Amir-imani/Autonomous-Mobile-Robot/mechanical/2.pdf

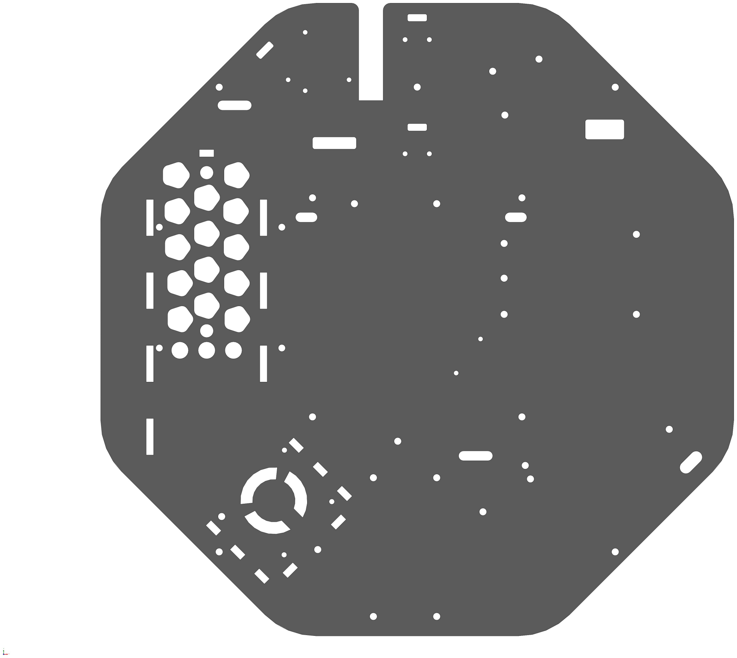
[picture p7: page 1]
