Amir-imani/Autonomous-Mobile-Robot/mechanical/AS5600.pdf

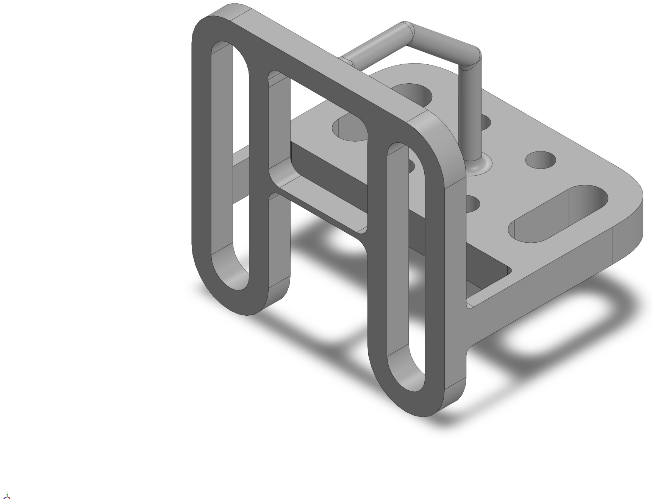
[picture p8: page 1]
