Amir-imani/Autonomous-Mobile-Robot/mechanical/camera holder.pdf

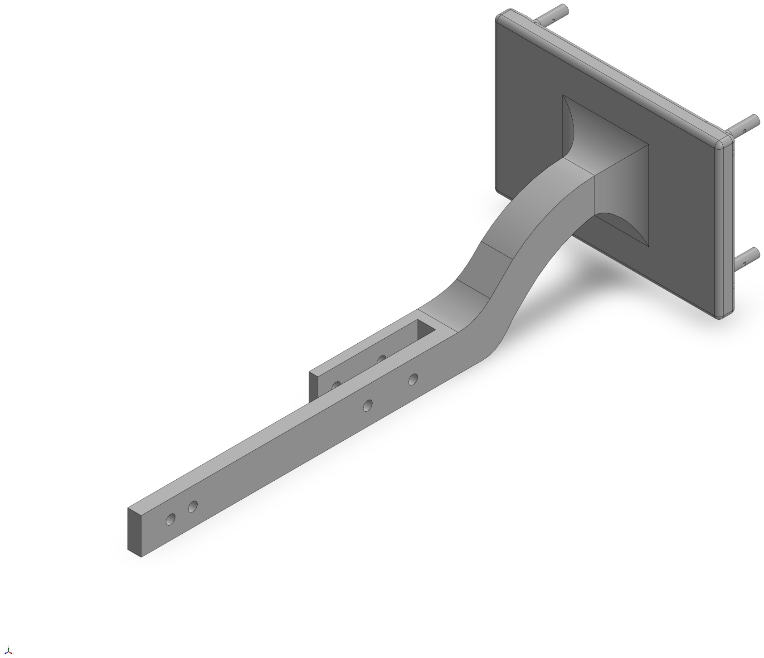
[picture p9: page 1]
