Amir-imani/Autonomous-Mobile-Robot/mechanical/encoder_couplers/magnet_shaft_coupler.pdf

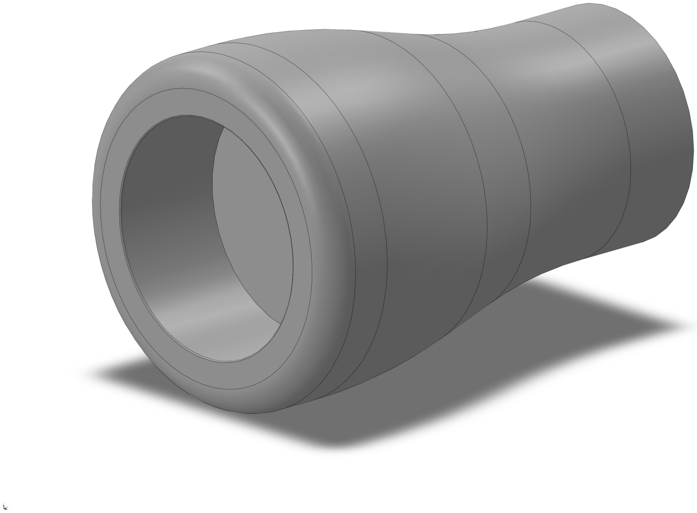
[picture p10: page 1]
