Amir-imani/Autonomous-Mobile-Robot/mechanical/motor_mounts/motor_mount_bracket.pdf

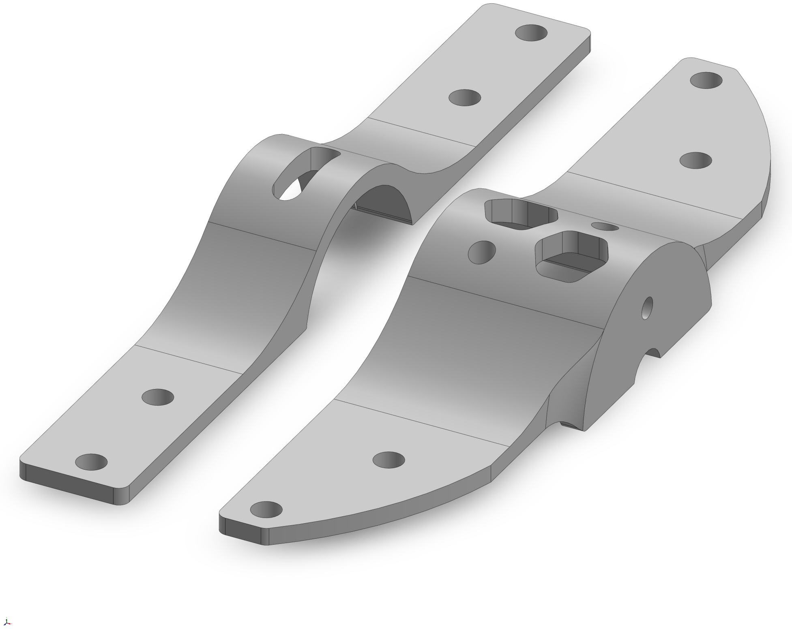
[picture p11: page 1]
