Amir-imani/Autonomous-Mobile-Robot/mechanical/sensor_mounts/lidar_mount.pdf

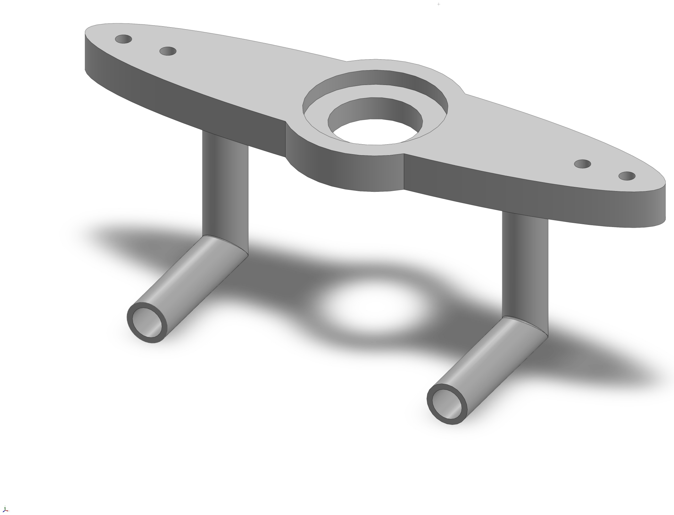
[picture p12: page 1]
