Amir-imani/Autonomous-Mobile-Robot/mechanical/thermal_airflow/raspberry_pi5_fan_duct.pdf

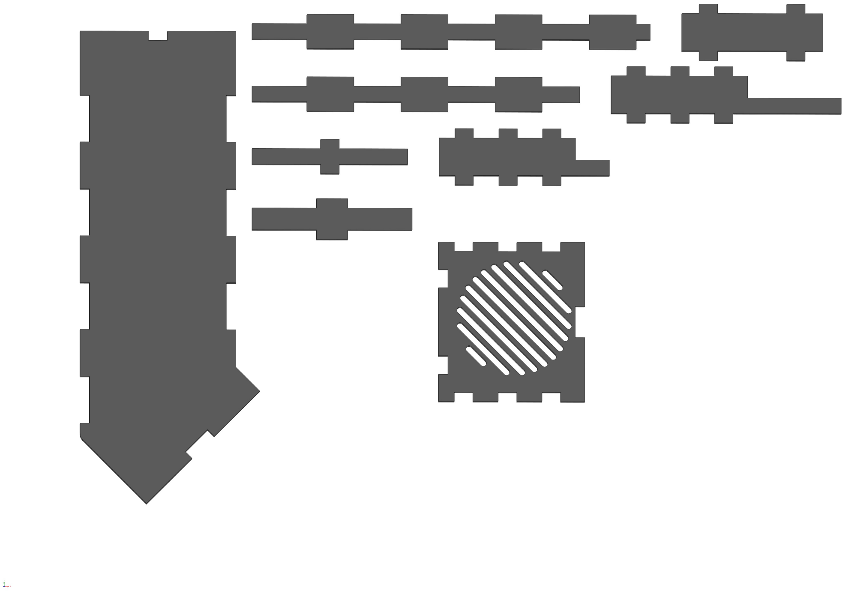
[picture p13: page 1]
