Amir-imani/Autonomous-Mobile-Robot/mechanical/chassis/lower_deck/lower_chassis_plate.pdf

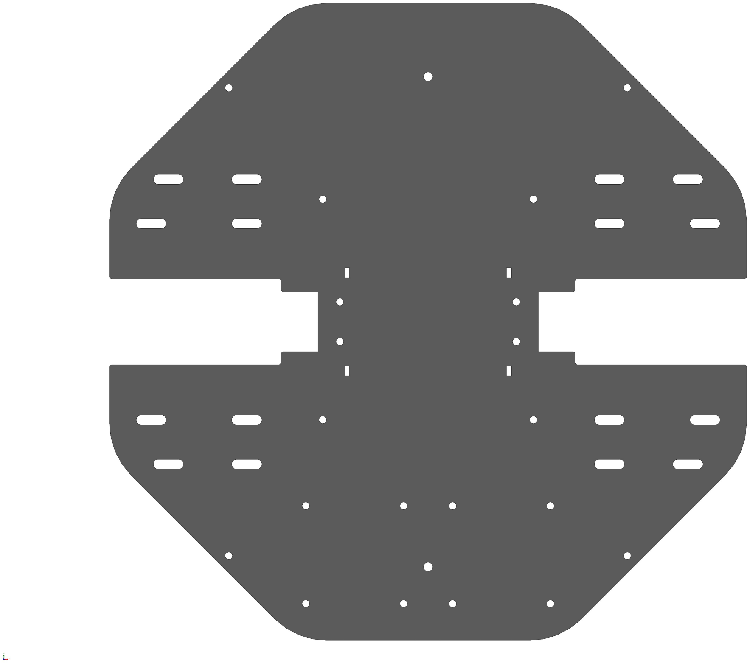
[picture p14: page 1]
