Amir-imani/Autonomous-Mobile-Robot/mechanical/chassis/lower_deck/lower_chassis_plate.SLDPRT

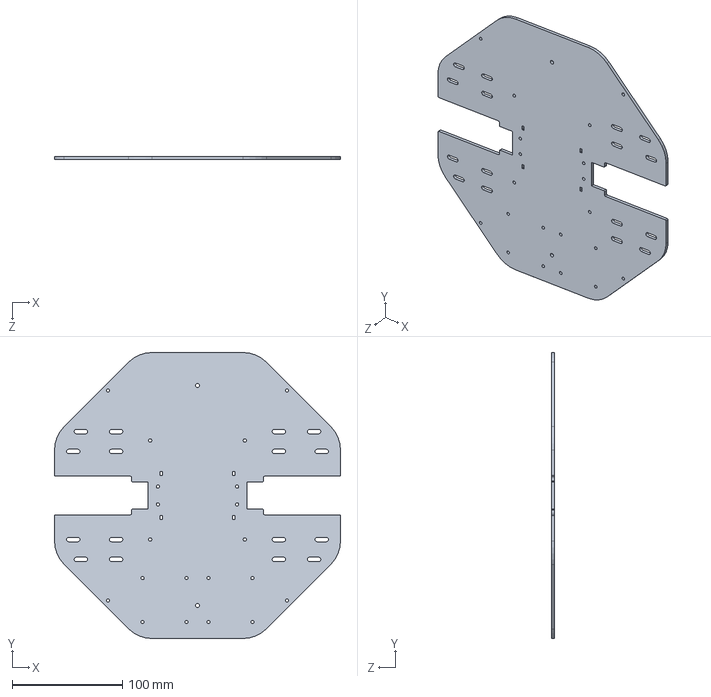
[picture p15: CAD file, 2026-10-11]
mechanical/chassis/lower_deck/lower_chassis_plate.SLDPRT
260.0 x 260.0 x 3.00 mm
