Amir-imani/Autonomous-Mobile-Robot/mechanical/motor_mounts/motor_mount_bracket.STL

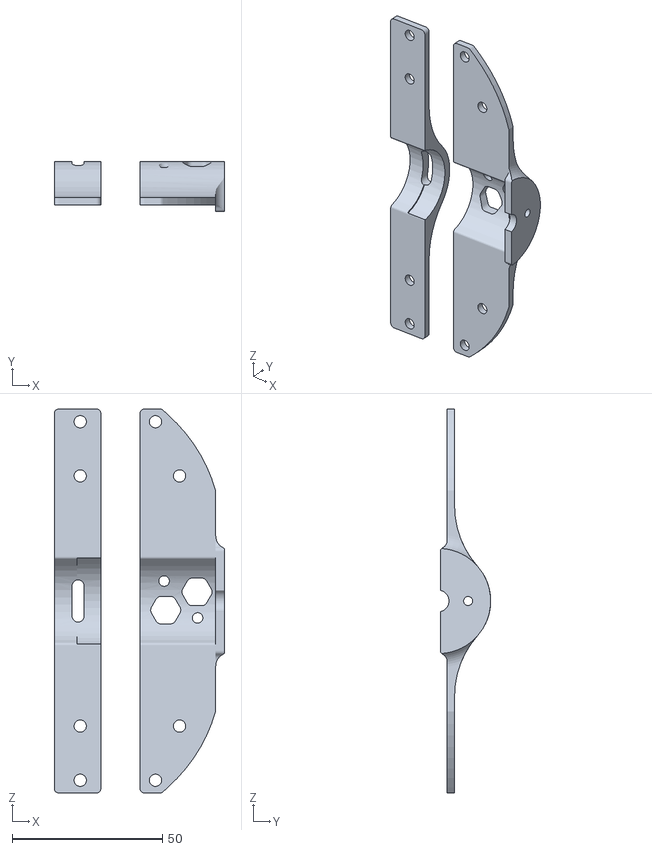
[picture p16: CAD file, 2026-10-11]
mechanical/motor_mounts/motor_mount_bracket.STL
56.6 x 16.7 x 127.6
