Amir-imani/Autonomous-Mobile-Robot/mechanical/sensor_mounts/lidar_mount.SLDPRT

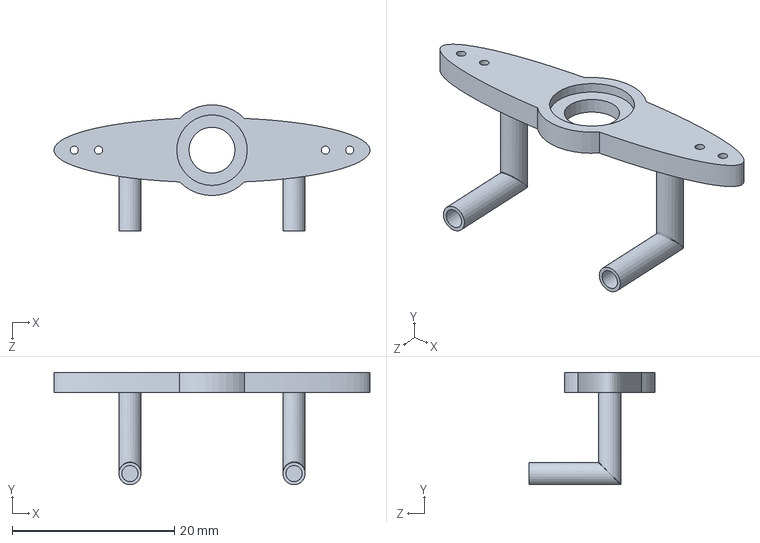
[picture p17: CAD file, 2026-10-11]
mechanical/sensor_mounts/lidar_mount.SLDPRT
39.0 x 13.9 x 15.6 mm
