Amir-imani/Autonomous-Mobile-Robot/mechanical/Side.SLDPRT

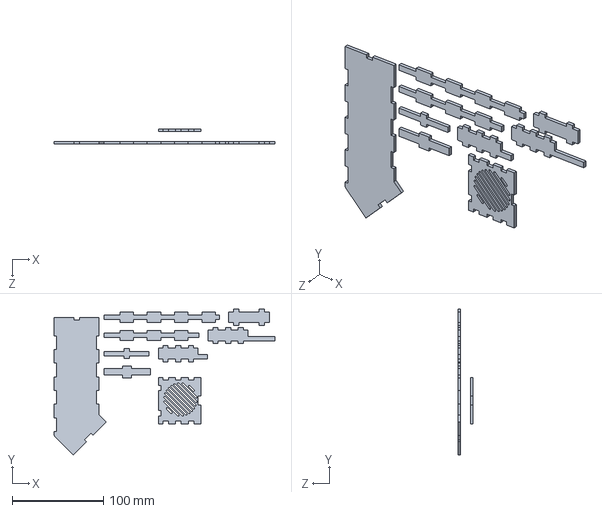
[picture p18: CAD file, 2026-10-11]
mechanical/Side.SLDPRT
242.7 x 160.2 x 16.9 mm
