Amir-imani/Autonomous-Mobile-Robot/mechanical/sensor_mounts/camera_mount.SLDPRT

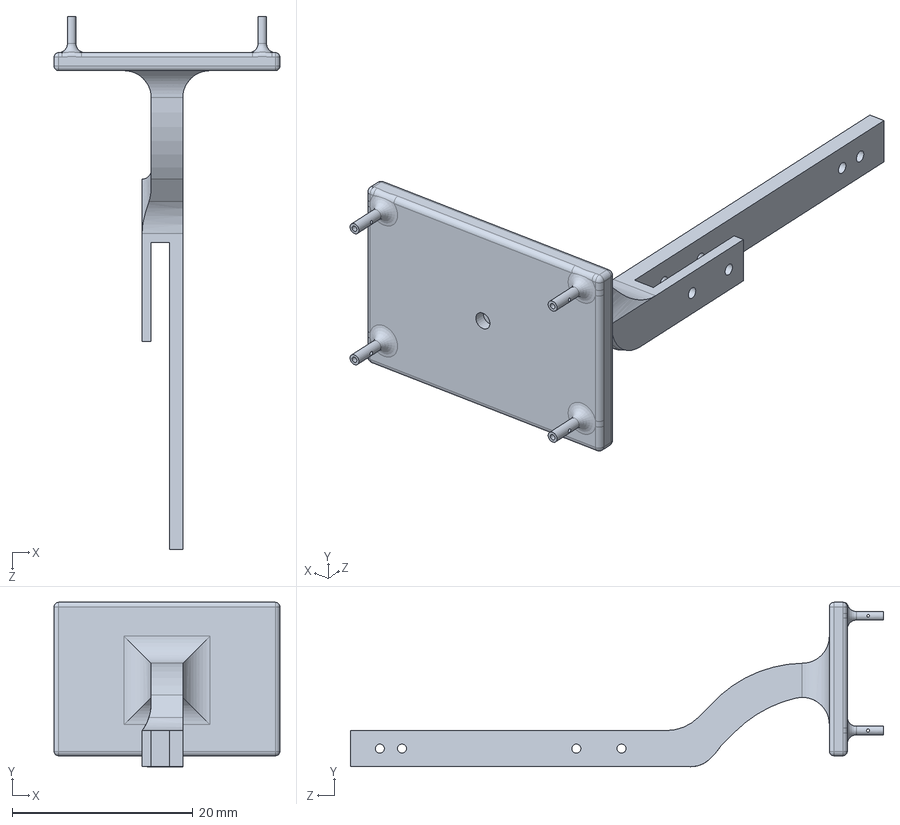
[picture p19: CAD file, 2026-10-11]
mechanical/sensor_mounts/camera_mount.SLDPRT
25.0 x 18.2 x 59.0 mm
