Amir-imani/Autonomous-Mobile-Robot/mechanical/Part21.SLDPRT

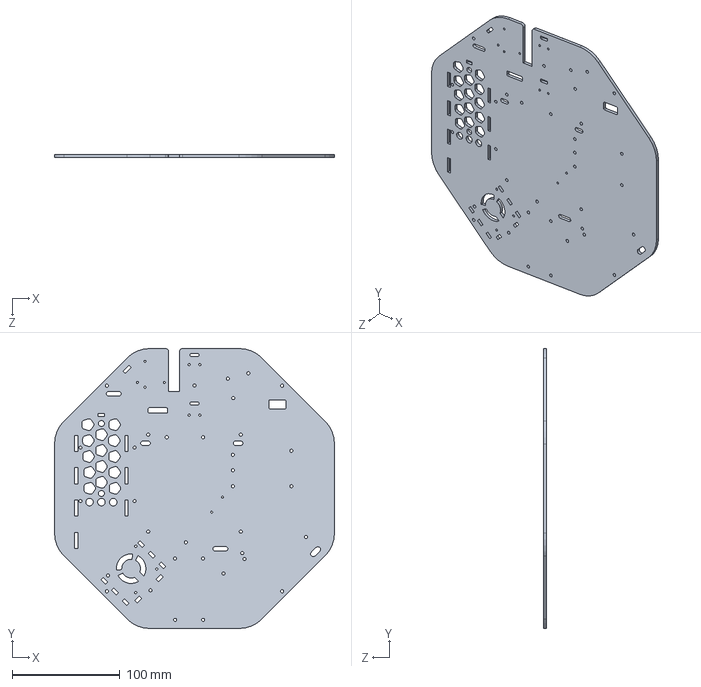
[picture p20: CAD file, 2026-10-11]
mechanical/Part21.SLDPRT
260.0 x 260.0 x 3.00 mm
