Amir-imani/Autonomous-Mobile-Robot/mechanical/sensor_mounts/as5600_encoder_mount.SLDPRT

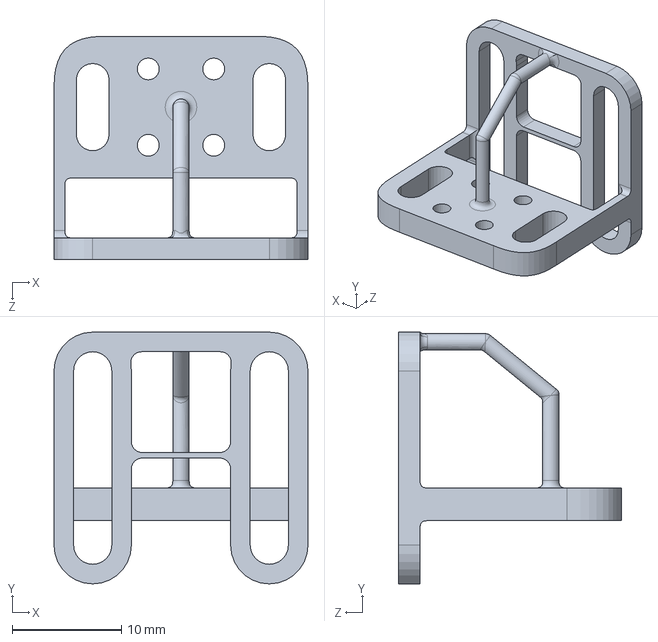
[picture p21: CAD file, 2026-10-11]
mechanical/sensor_mounts/as5600_encoder_mount.SLDPRT
23.3 x 23.1 x 20.5 mm
