Amir-imani/Autonomous-Mobile-Robot/mechanical/mag.SLDPRT

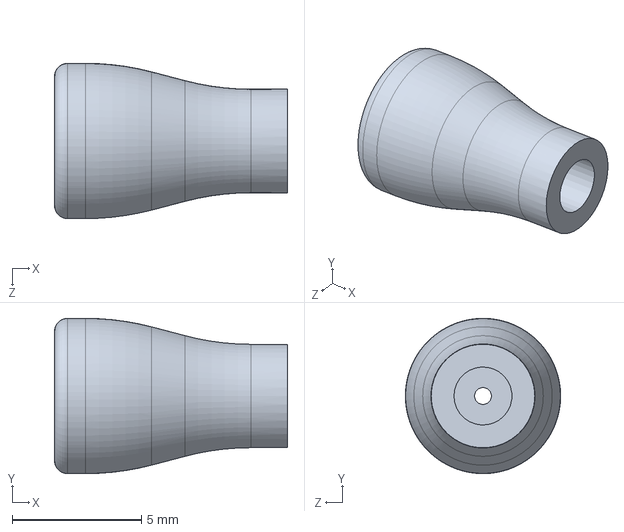
[picture p22: CAD file, 2026-10-11]
mechanical/mag.SLDPRT
9.00 x 6.00 x 6.00 mm
