Amir-imani/Autonomous-Mobile-Robot/mechanical/AS5600.STL

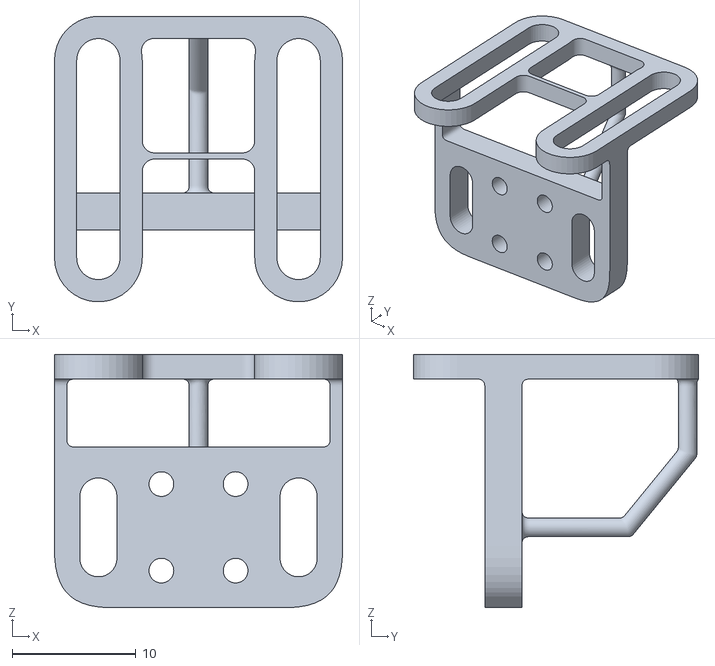
[picture p23: CAD file, 2026-10-11]
mechanical/AS5600.STL
23.3 x 23.1 x 20.5
