Amir-imani/Autonomous-Mobile-Robot/(list of files, cad)

Other CAD files:
mechanical/4.1.SLDPRT
mechanical/camera.STL
mechanical/mag.STL
mechanical/sensor_mounts/lidar_mount.STL
