Amir-imani/Autonomous-Mobile-Robot/hardware/stm8_fan_controller/schematic/Fan_robot_V3.pdf

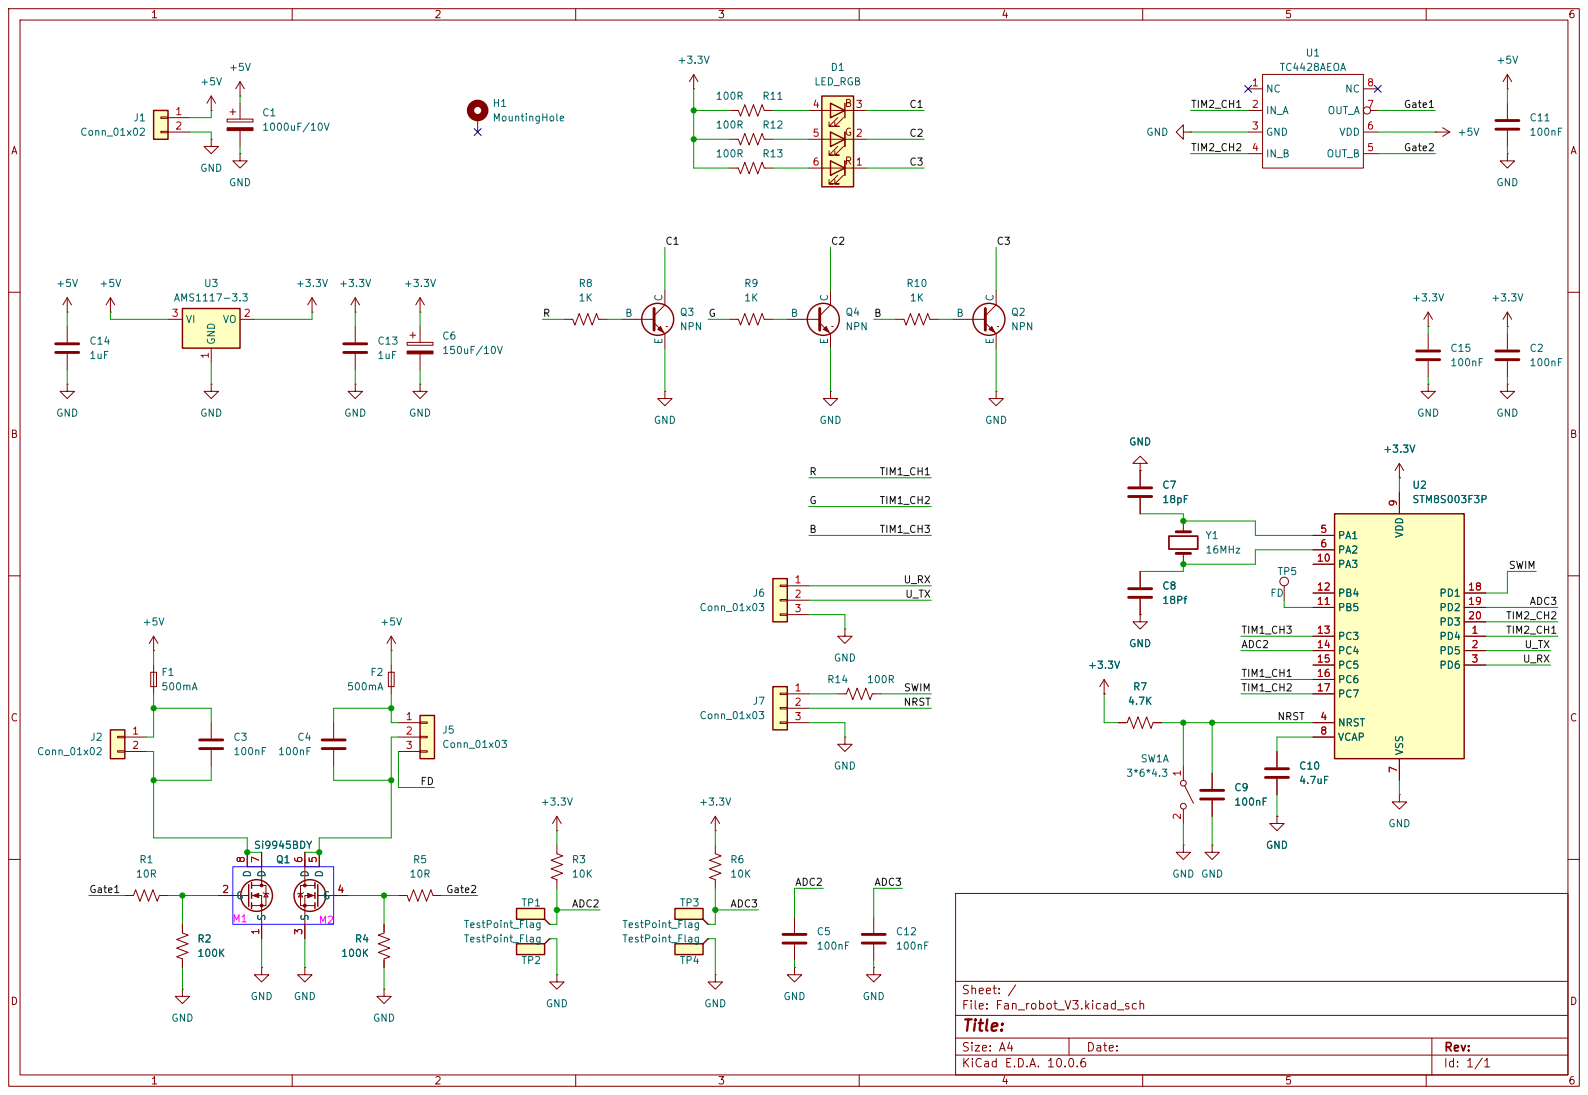
[picture p24: page 1]

Size: A4 | Rev:
KiCad E.D.A. 10.0.6 | Id: 1/1
