Amir-imani/Autonomous-Mobile-Robot/hardware/motor_power_distribution/source/Motor_P_robot.kicad_pcb

## KiCad design hardware/motor_power_distribution/source/Motor_P_robot.kicad_pcb (2026-10-10)

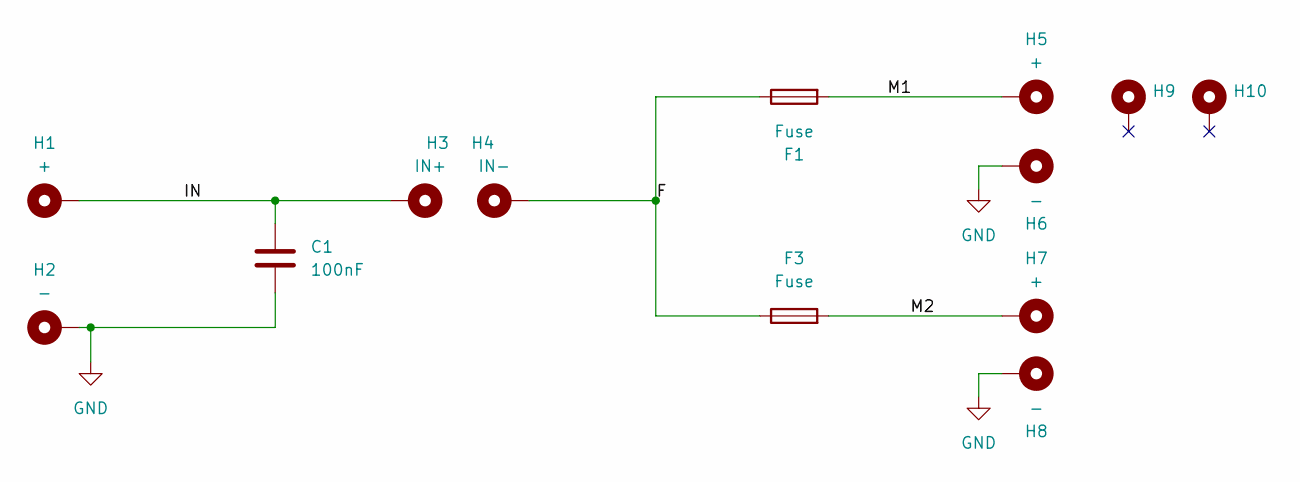
[picture p25: schematic Motor_P_robot.kicad_sch]

Parts:
C1: 100nF; C_1206_3216Metric_Pad1.33x1.80mm_HandSolder
F1, F3: Fuse; Fuse_Blade_ATO_directSolder
H1, H5, H7: +; MountingHole_2.2mm_M2_Pad_Via
H2, H6, H8: -; MountingHole_2.2mm_M2_Pad_Via
H3: IN+; MountingHole_2.2mm_M2_Pad_Via
H4: IN-; MountingHole_2.2mm_M2_Pad_Via
H9, H10: MountingHole_3.2mm_M3_Pad_Via

Connections:
/F: F1.1, F3.1, H4.1
/IN: C1.1, H1.1, H3.1
/M1: F1.2, H5.1
/M2: F3.2, H7.1
GND: C1.2, H2.1, H6.1, H8.1

Board: 2 copper layers, 13 parts (0 on the bottom side), 5 nets, no tracks yet.
