Amir-imani/Autonomous-Mobile-Robot/hardware/main_power_distribution/source/Input Power_robot.kicad_pcb

## KiCad design hardware/main_power_distribution/source/Input Power_robot.kicad_pcb (2026-10-10)

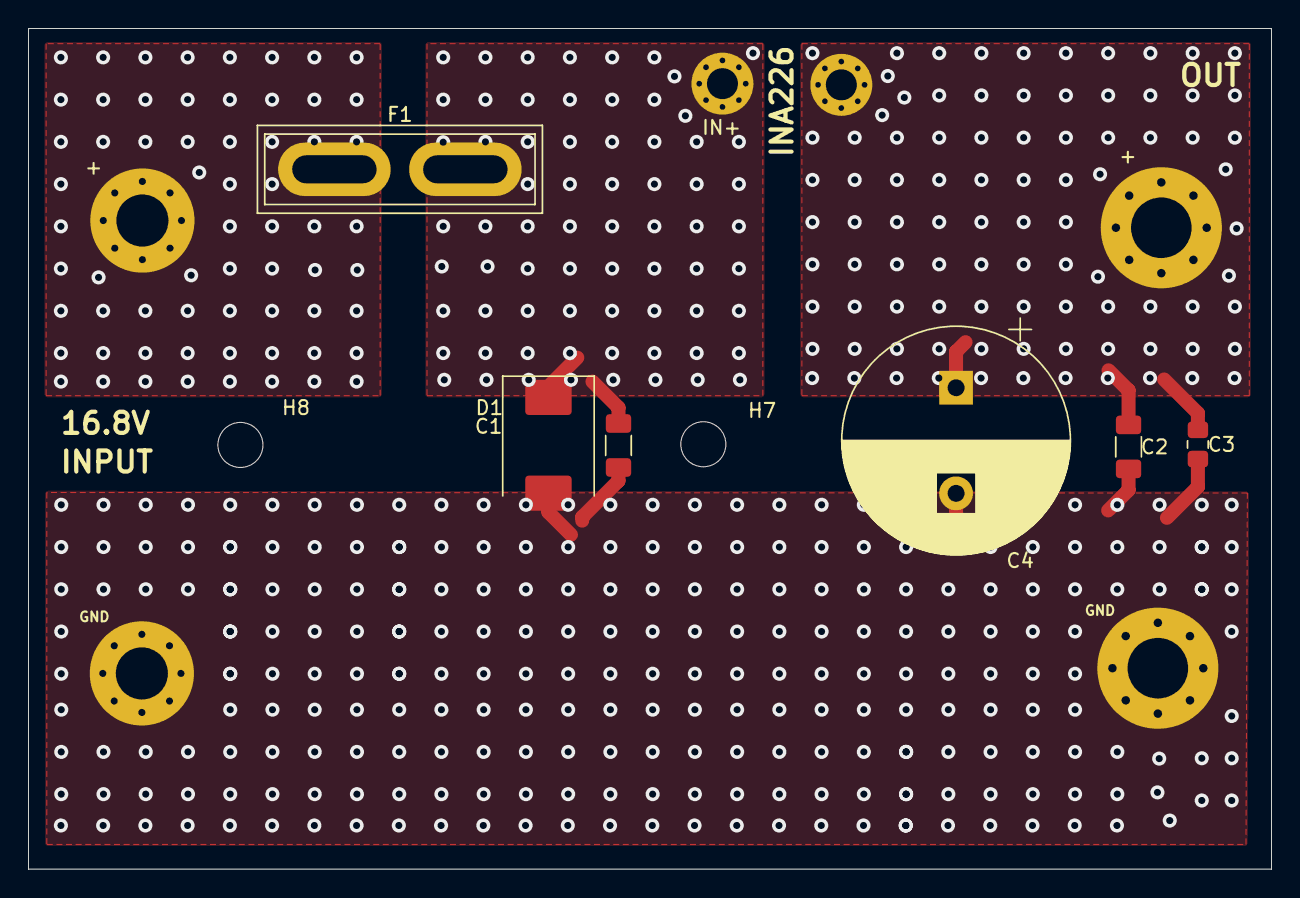
[picture p26: board Input Power_robot.kicad_pcb from above]

Board: 2 copper layers, 88.3 x 59.7 mm, 14 parts (0 on the bottom side), 4 nets.

Parts:
+: IN; MountingHole_3.7mm_Pad_Via
+#2: OUT; MountingHole_4.3mm_M4_Pad_Via
C1, C2: 100nF; C_1206_3216Metric_Pad1.33x1.80mm_HandSolder
C3: 1uF; C_0805_2012Metric_Pad1.18x1.45mm_HandSolder
C4: 2200uF/35V; CP_Radial_D16.0mm_P7.50mm
D1: SMCJ18CA; D_SMC
F1: Fuse; Fuse_Blade_ATO_directSolder
GND: OUT; MountingHole_4.3mm_M4_Pad_Via
GND#2: IN; MountingHole_3.7mm_Pad_Via
H4: IN-; MountingHole_2.2mm_M2_Pad_Via
H7, H8: P; MountingHole_3.2mm_M3
IN+: IN+; MountingHole_2.2mm_M2_Pad_Via

Connections:
+16.8V: C1.1, D1.1 (A1), F1.2, IN+.1
+16.8V_R: +#2.1, C2.1, C3.1, C4.1, H4.1
+16.8V_U: +.1, F1.1
GND: C1.2, C2.2, C3.2, C4.2, D1.2 (A2), GND.1, GND#2.1
