Amir-imani/Autonomous-Mobile-Robot/hardware/stm8_fan_controller/source/Fan_robot_V3.kicad_pcb

## KiCad design hardware/stm8_fan_controller/source/Fan_robot_V3.kicad_pcb (2026-10-10)

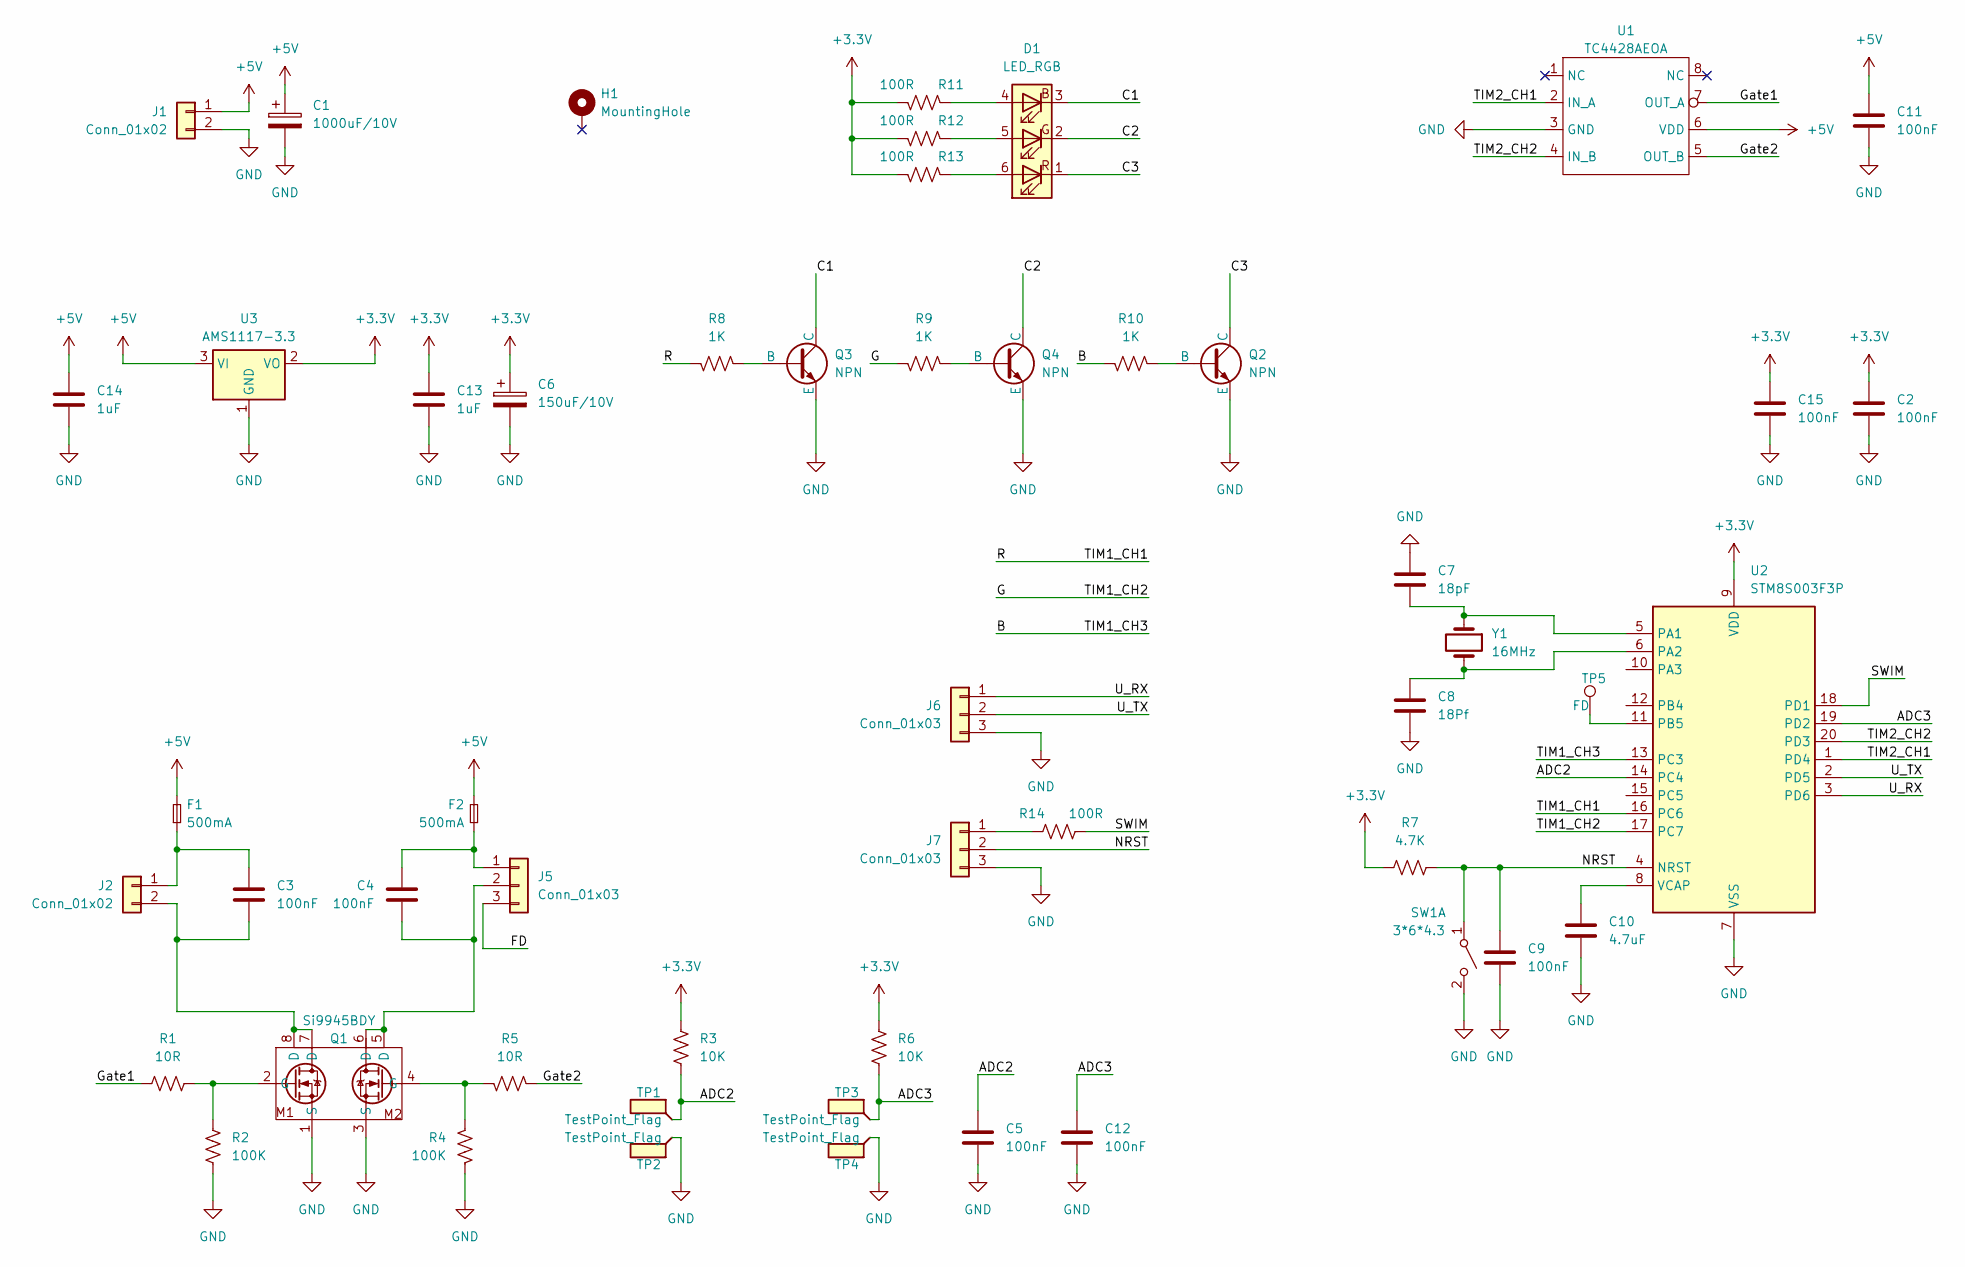
[picture p27: schematic Fan_robot_V3.kicad_sch]

Parts:
C1: 1000uF/10V; CP_Radial_D10.0mm_P5.00mm
C2, C3, C4, C5, C9, C11, C12, C15: 100nF; C_0805_2012Metric_Pad1.18x1.45mm_HandSolder
C6: 150uF/10V; CP_Elec_6.3x5.3
C7: 18pF; C_0805_2012Metric_Pad1.18x1.45mm_HandSolder
C8: 18Pf; C_0805_2012Metric_Pad1.18x1.45mm_HandSolder
C10: 4.7uF; C_0805_2012Metric_Pad1.18x1.45mm_HandSolder
C13, C14: 1uF; C_0805_2012Metric_Pad1.18x1.45mm_HandSolder
D1: LED_RGB; LED_RGB_5050-6
F1, F2: 500mA; Fuse_0805_2012Metric_Pad1.15x1.40mm_HandSolder
H1: MountingHole; MountingHole_3.2mm_M3_Pad_Via
J1: Conn_01x02; JST_XH_B2B-XH-A_1x02_P2.50mm_Vertical
J2: Conn_01x02; PinHeader_1x02_P2.54mm_Vertical
J5, J6, J7: Conn_01x03; PinHeader_1x03_P2.54mm_Vertical
Q1: Si9945BDY; PowerIntegrations_SO-8
Q2, Q3, Q4: NPN; SOT-23
R1, R5: 10R; R_0805_2012Metric_Pad1.20x1.40mm_HandSolder
R2, R4: 100K; R_0805_2012Metric_Pad1.20x1.40mm_HandSolder
R3, R6: 10K; R_0805_2012Metric_Pad1.20x1.40mm_HandSolder
R7: 4.7K; R_0805_2012Metric_Pad1.20x1.40mm_HandSolder
R8, R9, R10: 1K; R_0805_2012Metric_Pad1.20x1.40mm_HandSolder
R11, R12, R13, R14: 100R; R_0805_2012Metric_Pad1.20x1.40mm_HandSolder
SW1: 3*6*4.3; SW_Tactile_SPST_NO_Straight_CK_PTS636Sx25SMTRLFS
TP1, TP2, TP3, TP4: TestPoint_Flag; TestPoint_Pad_1.0x1.0mm
TP5: FD; TestPoint_Pad_D1.0mm
U1: TC4428AEOA; PowerIntegrations_SO-8
U2: STM8S003F3P; TSSOP-20_4.4x6.5mm_P0.65mm
U3: AMS1117-3.3; SOT-223-3_TabPin2
Y1: 16MHz; Crystal_SMD_HC49-SD

Connections:
+3.3V: C2.1, C6.1, C13.1, C15.1, R3.2, R6.2, R7.1, R11.2, R12.2, R13.2, U2.9 (VDD), U3.2 (VO)
+5V: C1.1, C11.1, C14.1, F1.2, F2.2, J1.1, U1.6 (VDD), U3.3 (VI)
/ADC2: C5.1, R3.1, TP1.1, U2.14 (PC4)
/ADC3: C12.1, R6.1, TP3.1, U2.19 (PD2)
/B: R10.2, U2.13 (PC3)
/C1: D1.3 (BK), Q3.3 (C)
/C2: D1.2 (GK), Q4.3 (C)
/C3: D1.1 (RK), Q2.3 (C)
/FD: J5.3
/G: R9.2, U2.17 (PC7)
/Gate1: R1.1, U1.7 (OUT_A)
/Gate2: R5.1, U1.5 (OUT_B)
/NRST: C9.1, J7.2, R7.2, SW1.1 (A), U2.4 (NRST)
/R: R8.2, U2.16 (PC6)
/SWIM: R14.2, U2.18 (PD1)
/TIM2_CH1: U1.2 (IN_A), U2.1 (PD4)
/TIM2_CH2: U1.4 (IN_B), U2.20 (PD3)
/U_RX: J6.1, U2.3 (PD6)
/U_TX: J6.2, U2.2 (PD5)
GND: C1.2, C2.2, C5.2, C6.2, C7.1, C8.2, C9.2, C10.2, C11.2, C12.2, C13.2, C14.2, C15.2, J1.2, J6.3, J7.3, Q1.1 (S), Q1.3 (S), Q2.2 (E), Q3.2 (E), Q4.2 (E), R2.1, R4.1, SW1.2 (B), TP2.1, TP4.1, U1.3 (GND), U2.7 (VSS), U3.1 (GND)
unnamed: D1.4 (BA), R11.1
unnamed: D1.5 (GA), R12.1
unnamed: D1.6 (RA), R13.1
unnamed: C3.1, F1.1, J2.1
unnamed: C3.2, J2.2, Q1.7 (D), Q1.8 (D)
unnamed: C4.1, F2.1, J5.1
unnamed: C4.2, J5.2, Q1.5 (D), Q1.6 (D)
unnamed: J7.1, R14.1
unnamed: Q1.2 (G), R1.2, R2.2
unnamed: Q1.4 (G), R4.2, R5.2
unnamed: Q2.1 (B), R10.1
unnamed: Q3.1 (B), R8.1
unnamed: Q4.1 (B), R9.1
unnamed: C7.2, U2.5 (PA1), Y1.1
unnamed: C8.1, U2.6 (PA2), Y1.2
unnamed: TP5.1, U2.11 (PB5)
unnamed: C10.1, U2.8 (VCAP)

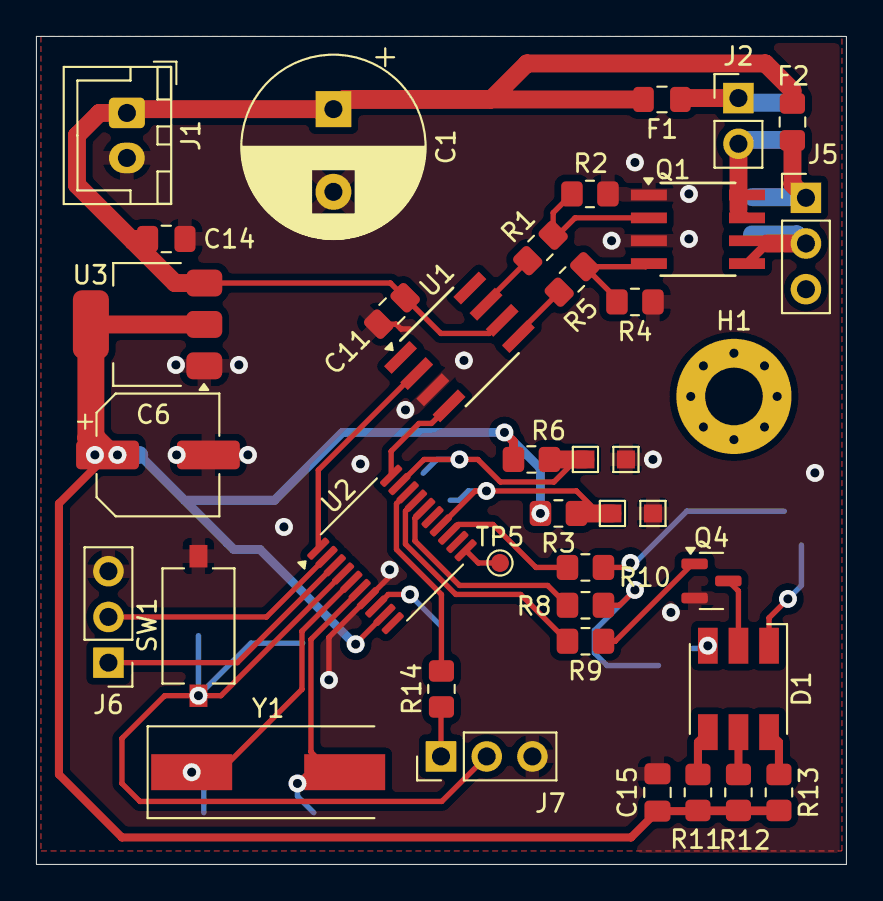
[picture p28: board Fan_robot_V3.kicad_pcb from above]

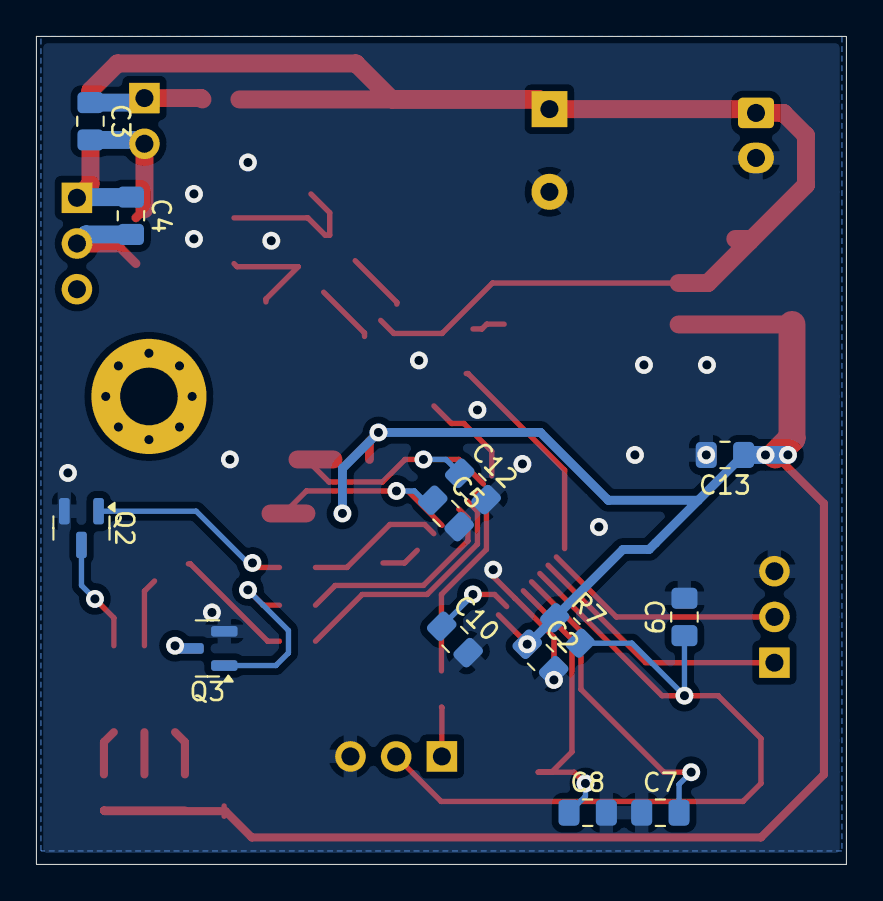
[picture p29: board Fan_robot_V3.kicad_pcb from below]

Board: 2 copper layers, 45.0 x 46.0 mm, 52 parts (13 on the bottom side), 36 nets.
