Amir-imani/Autonomous-Mobile-Robot/hardware/raspberry_pi5_overvoltage_protection/source/RP_robot.kicad_pcb

## KiCad design hardware/raspberry_pi5_overvoltage_protection/source/RP_robot.kicad_pcb (2026-10-10)

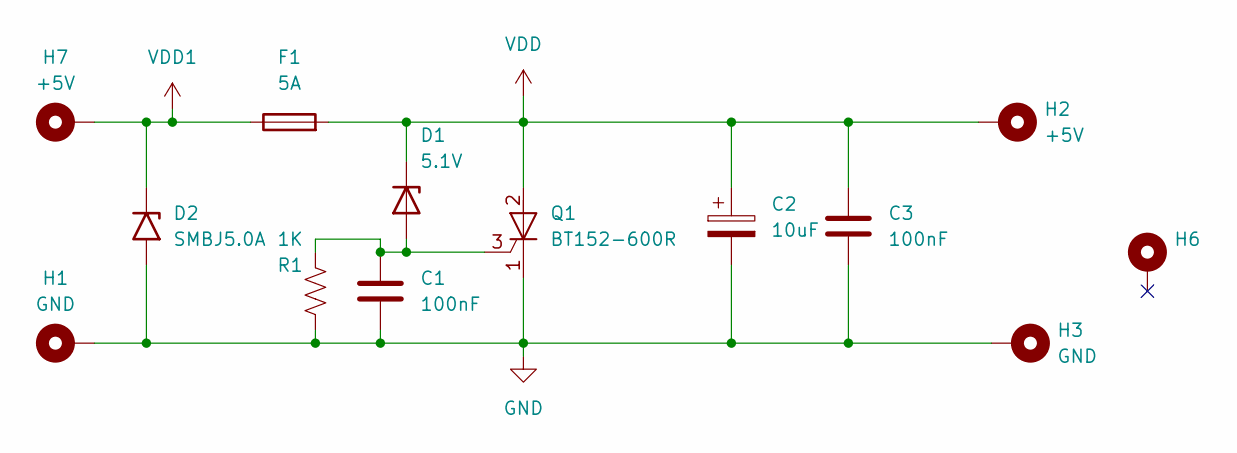
[picture p30: schematic RP_robot.kicad_sch]

Parts:
C1, C3: 100nF; C_0805_2012Metric_Pad1.18x1.45mm_HandSolder
C2: 10uF; CP_Elec_6.3x5.3
D1: 5.1V; D_MELF
D2: SMBJ5.0A; D_SMB
F1: 5A; Fuse_1206_3216Metric_Pad1.42x1.75mm_HandSolder
H1, H3: GND; MountingHole_2.2mm_M2_Pad_Via
H2, H7: +5V; MountingHole_2.2mm_M2_Pad_Via
H6: +5V; MountingHole_3.2mm_M3
Q1: BT152-600R; TO-218-3_Horizontal_TabDown
R1: 1K; R_0805_2012Metric_Pad1.20x1.40mm_HandSolder

Connections:
GND: C1.2, C2.2, C3.2, D2.2 (A2), H1.1, H3.1, Q1.1 (K), R1.2
unnamed: C1.1, D1.2 (A), Q1.3 (G), R1.1
VDD: C2.1, C3.1, D1.1 (K), F1.2, H2.1, Q1.2 (A)
VDD1: D2.1 (A1), F1.1, H7.1

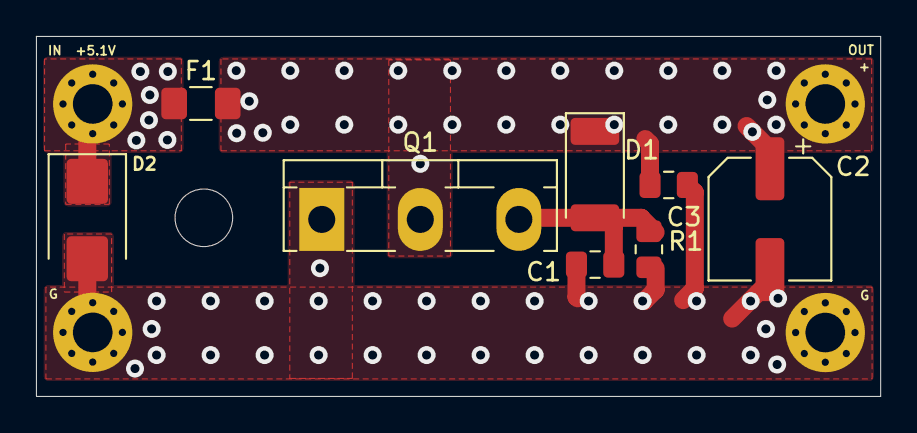
[picture p31: board RP_robot.kicad_pcb from above]

Board: 2 copper layers, 46.9 x 20.0 mm, 13 parts (0 on the bottom side), 4 nets.
