Amir-imani/Autonomous-Mobile-Robot/hardware/pico_carrier_board/source/RP_Pico_robot.kicad_pcb

## KiCad design hardware/pico_carrier_board/source/RP_Pico_robot.kicad_pcb (2026-10-10)

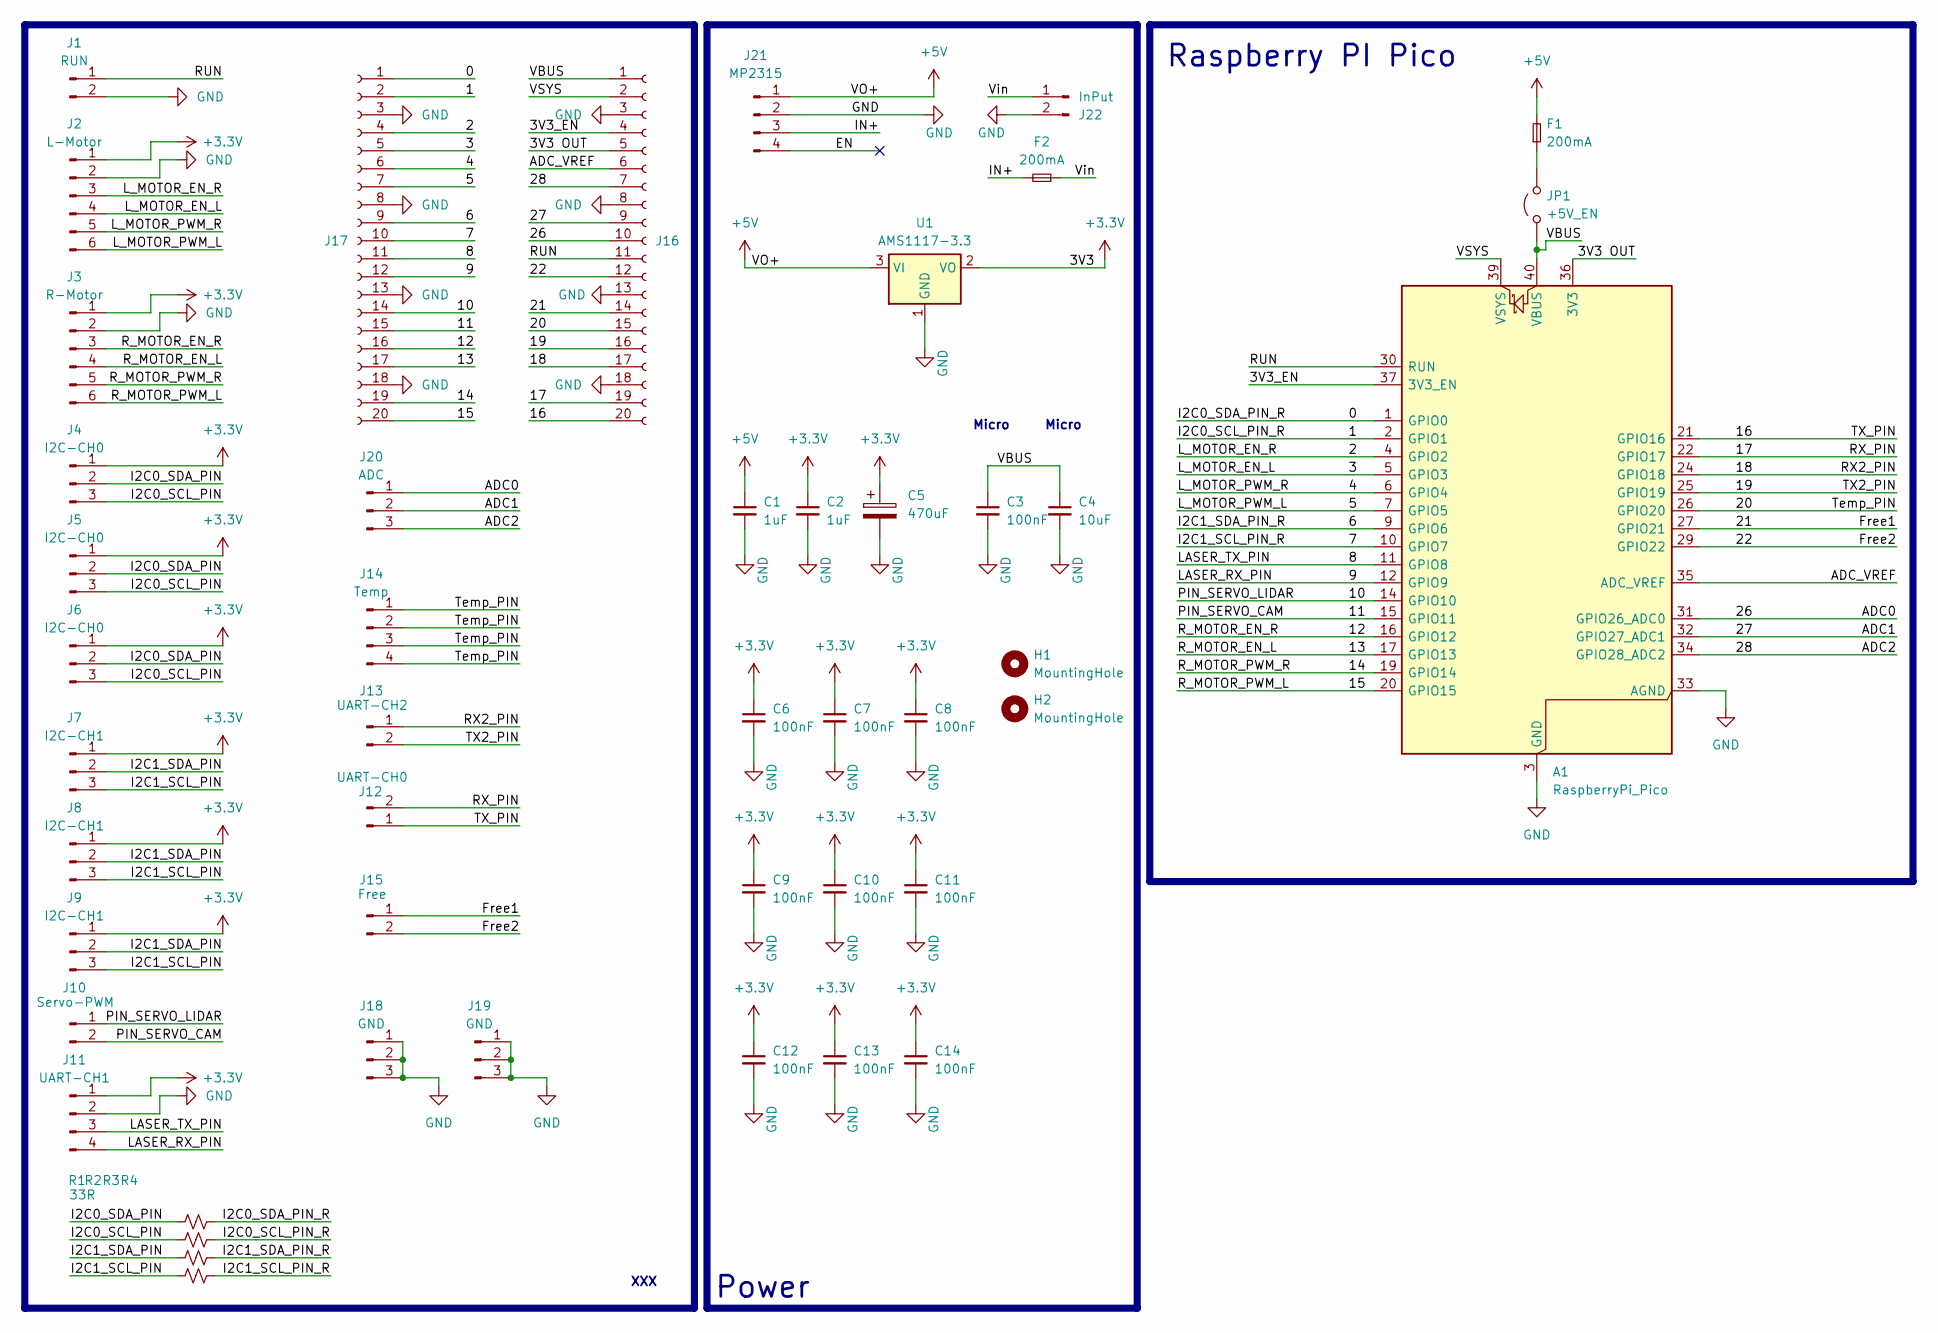
[picture p32: schematic RP_Pico_robot.kicad_sch]

Parts:
A1: RaspberryPi_Pico; RaspberryPi_Pico_Common_Unspecified
C1, C2: 1uF; C_0805_2012Metric_Pad1.18x1.45mm_HandSolder
C3, C6, C7, C8, C9, C10, C11, C12, C13, C14: 100nF; C_0805_2012Metric_Pad1.18x1.45mm_HandSolder
C4: 10uF; C_0805_2012Metric_Pad1.18x1.45mm_HandSolder
C5: 470uF; CP_Radial_D8.0mm_P3.80mm
F1, F2: 200mA; Fuse_0805_2012Metric_Pad1.15x1.40mm_HandSolder
H1, H2: MountingHole; MountingHole_3mm_Pad_Via
J1: RUN; JST_XH_B2B-XH-A_1x02_P2.50mm_Vertical
J2: L-Motor; JST_XH_B6B-XH-A_1x06_P2.50mm_Vertical
J3: R-Motor; JST_XH_B6B-XH-A_1x06_P2.50mm_Vertical
J4, J5, J6: I2C-CH0; JST_XH_B3B-XH-A_1x03_P2.50mm_Vertical
J7, J8, J9: I2C-CH1; JST_XH_B3B-XH-A_1x03_P2.50mm_Vertical
J10: Servo-PWM; JST_XH_B2B-XH-A_1x02_P2.50mm_Vertical
J11: UART-CH1; JST_XH_B4B-XH-A_1x04_P2.50mm_Vertical
J12: UART-CH0; JST_XH_B2B-XH-A_1x02_P2.50mm_Vertical
J13: UART-CH2; JST_XH_B2B-XH-A_1x02_P2.50mm_Vertical
J14: Temp; JST_XH_B4B-XH-A_1x04_P2.50mm_Vertical
J15: Free; JST_XH_B2B-XH-A_1x02_P2.50mm_Vertical
J16, J17: Conn_01x20_Socket; PinHeader_1x20_P2.54mm_Vertical
J18, J19: GND; JST_XH_B3B-XH-A_1x03_P2.50mm_Vertical
J20: ADC; JST_XH_B3B-XH-A_1x03_P2.50mm_Vertical
J21: MP2315; PinHeader_1x04_P2.54mm_Vertical
J22: InPut; JST_XH_B2B-XH-A_1x02_P2.50mm_Vertical
JP1: +5V_EN; TestPoint_2Pads_Pitch2.54mm_Drill0.8mm
R1, R2, R3, R4: 33R; R_0805_2012Metric_Pad1.20x1.40mm_HandSolder
U1: AMS1117-3.3; SOT-223-3_TabPin2

Connections:
+3.3V: C2.1, C5.1, C6.1, C7.1, C8.1, C9.1, C10.1, C11.1, C12.1, C13.1, C14.1, J2.1, J3.1, J4.1, J5.1, J6.1, J7.1, J8.1, J9.1, J11.1, U1.2 (VO)
+5V: C1.1, F1.2, J21.1, U1.3 (VI)
/0: A1.1 (GPIO0), J17.1, R1.2
/1: A1.2 (GPIO1), J17.2, R2.2
/2: A1.4 (GPIO2), J2.3, J17.4
/3: A1.5 (GPIO3), J2.4, J17.5
/3V3 OUT: A1.36 (3V3), J16.5
/3V3_EN: A1.37 (3V3_EN), J16.4
/4: A1.6 (GPIO4), J2.5, J17.6
/5: A1.7 (GPIO5), J2.6, J17.7
/6: A1.9 (GPIO6), J17.9, R3.2
/7: A1.10 (GPIO7), J17.10, R4.2
/8: A1.11 (GPIO8), J11.3, J17.11
/9: A1.12 (GPIO9), J11.4, J17.12
/10: A1.14 (GPIO10), J10.1, J17.14
/11: A1.15 (GPIO11), J10.2, J17.15
/12: A1.16 (GPIO12), J3.3, J17.16
/13: A1.17 (GPIO13), J3.4, J17.17
/14: A1.19 (GPIO14), J3.5, J17.19
/15: A1.20 (GPIO15), J3.6, J17.20
/16: A1.21 (GPIO16), J12.1, J16.20
/17: A1.22 (GPIO17), J12.2, J16.19
/18: A1.24 (GPIO18), J13.1, J16.17
/19: A1.25 (GPIO19), J13.2, J16.16
/20: A1.26 (GPIO20), J14.1, J14.2, J14.3, J14.4, J16.15
/21: A1.27 (GPIO21), J15.1, J16.14
/22: A1.29 (GPIO22), J15.2, J16.12
/26: A1.31 (GPIO26_ADC0), J16.10, J20.1
/27: A1.32 (GPIO27_ADC1), J16.9, J20.2
/28: A1.34 (GPIO28_ADC2), J16.7, J20.3
/ADC_VREF: A1.35 (ADC_VREF), J16.6
/EN: J21.4
/I2C0_SCL_PIN: J4.3, J5.3, J6.3, R2.1
/I2C0_SDA_PIN: J4.2, J5.2, J6.2, R1.1
/I2C1_SCL_PIN: J7.3, J8.3, J9.3, R4.1
/I2C1_SDA_PIN: J7.2, J8.2, J9.2, R3.1
/IN+: F2.2, J21.3
/RUN: A1.30 (RUN), J1.1, J16.11
/VBUS: A1.40 (VBUS), C3.1, C4.1, J16.1, JP1.1 (A)
/VSYS: A1.39 (VSYS), J16.2
/Vin: F2.1, J22.1
GND: A1.3 (GND), A1.8 (GND), A1.13 (GND), A1.18 (GND), A1.23 (GND), A1.28 (GND), A1.33 (AGND), A1.38 (GND), C1.2, C2.2, C3.2, C4.2, C5.2, C6.2, C7.2, C8.2, C9.2, C10.2, C11.2, C12.2, C13.2, C14.2, J1.2, J2.2, J3.2, J11.2, J16.3, J16.8, J16.13, J16.18, J17.3, J17.8, J17.13, J17.18, J18.1, J18.2, J18.3, J19.1, J19.2, J19.3, J21.2, J22.2, U1.1 (GND)
unnamed: F1.1, JP1.2 (B)

Notes on the sheet:
XXX
Raspberry PI Pico
Micro
Power

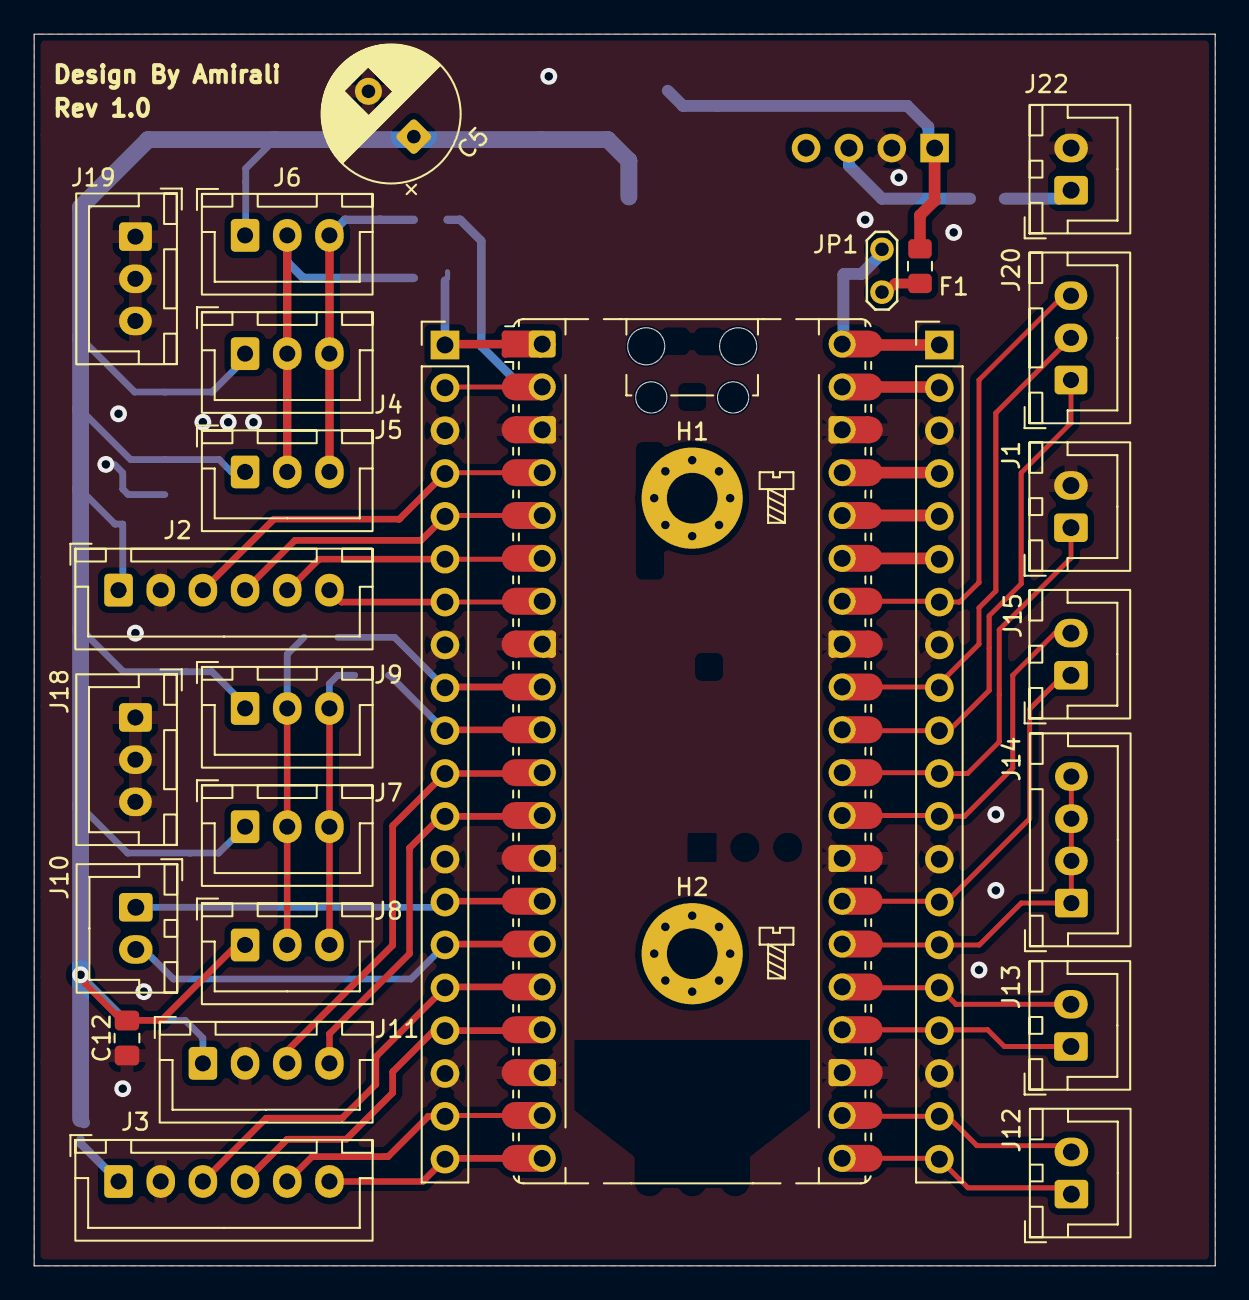
[picture p33: board RP_Pico_robot.kicad_pcb from above]

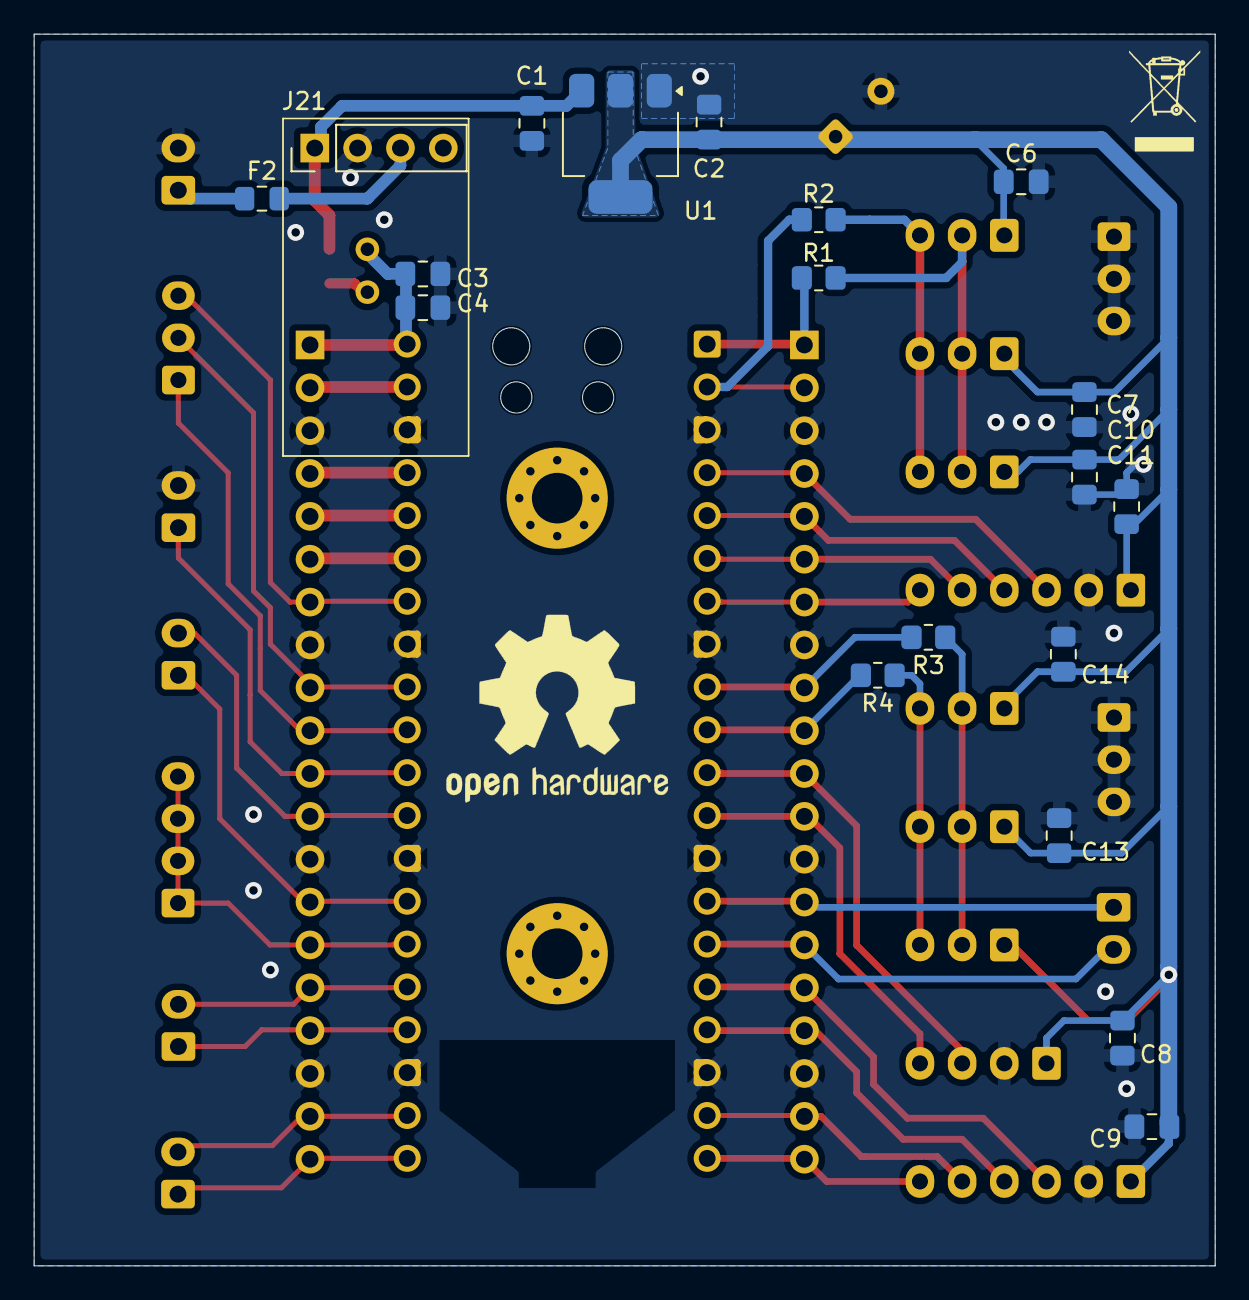
[picture p34: board RP_Pico_robot.kicad_pcb from below]

Board: 2 copper layers, 70.0 x 73.0 mm, 47 parts (19 on the bottom side), 42 nets.
