Amir-imani/Autonomous-Mobile-Robot/(commit log)

2026-10-09 Add Encoder_AS5600.h
2026-10-09 Add Filters.h
2026-10-09 Add IMU_9DOF.h
2026-10-09 Add Laser_Scanner.h
2026-10-09 Add Motor_BTS7960.h
2026-10-09 Add Power_Monitor.h
2026-10-09 Complete Pico protocol and encoder sources
2026-10-09 Add remaining Pico driver implementations
2026-10-09 Add Pico power, serial, and servo implementations
2026-10-09 Add Neuro-PID training and ROS 2 bridge package metadata
2026-10-09 Add sensor Xacro and vision message/camera package files
2026-10-09 Add differential odometry node
2026-10-09 Add LiDAR scan aggregation node
2026-10-09 Add Arduino.h
2026-10-10 Add Pico carrier KiCad source: RP_Pico_robot.kicad_pro
2026-10-10 Add Pico carrier KiCad source: RP_Pico_robot.kicad_sch
2026-10-10 Stage Pico carrier hardware payload 1/5
2026-10-10 Stage Pico carrier hardware payload 2/5
2026-10-10 Stage Pico carrier hardware payload 3/5
2026-10-10 Stage Pico carrier hardware payload 4/5
2026-10-10 Stage Pico carrier hardware payload 5/5
2026-10-10 Add Pico carrier hardware assembly workflow
2026-10-10 Document Pico carrier board hardware files
2026-10-10 Trigger Pico carrier hardware assembly
2026-10-10 Assemble Pico carrier hardware artifacts
2026-10-10 Improve Pico carrier board documentation
2026-10-10 Remove one-time Pico carrier assembly workflow
2026-10-10 Stage RP5 protection hardware payload 1/4
2026-10-10 Stage RP5 protection hardware payload 2/4
2026-10-10 Stage RP5 protection hardware payload 3/4
2026-10-10 Stage RP5 protection hardware payload 4/4
2026-10-10 Add RP5 protection hardware assembly workflow
2026-10-10 Document Raspberry Pi 5 protection board
2026-10-10 Trigger RP5 protection board assembly
2026-10-10 Assemble Raspberry Pi 5 protection board artifacts
2026-10-10 Index Raspberry Pi 5 protection board
2026-10-10 Remove one-time RP5 hardware assembly workflow
2026-10-10 Stage STM8 fan board files 1/5
2026-10-10 Stage STM8 fan board files 2/6
2026-10-10 Stage STM8 fan board files 3/6
2026-10-10 Stage STM8 fan board files 4/6
2026-10-10 Stage STM8 fan board files 5/6
2026-10-10 Stage STM8 verified file manifest
2026-10-10 Add temporary STM8 hardware upload assembler
2026-10-10 Document STM8 board and thesis status
2026-10-10 Trigger STM8 hardware file assembly
2026-10-10 Add STM8 fan controller source, images and schematic
2026-10-10 Index STM8 fan control PCB
2026-10-10 Remove temporary STM8 assembly workflow
2026-10-10 Stage power board design assets 1/2
2026-10-10 Stage power board design assets 2/2
2026-10-10 Add temporary power boards assembly
2026-10-10 Document main power board
2026-10-10 Document motor power board
2026-10-10 Trigger power board assembly
2026-10-10 Add main and motor power distribution KiCad projects
2026-10-10 Index main and motor power distribution boards
2026-10-10 Remove temporary power-board upload workflow
2026-10-11 Stage mechanical design archive 1/8
2026-10-11 Stage mechanical design archive 2/8
2026-10-11 Stage mechanical design archive 3/8
2026-10-11 Stage mechanical design archive 4/8
2026-10-11 Stage mechanical design archive 5/8
2026-10-11 Stage mechanical design archive 6/8
2026-10-11 Stage mechanical design archive 7/8
2026-10-11 docs: add Appendix B circuit and PCB source index
2026-10-11 docs: expose circuit Appendix B from repository landing page
2026-10-11 docs: add Appendix C mechanical CAD, quantities and materials
2026-10-11 docs: describe mechanical materials quantities and source formats
2026-10-11 docs: add Appendix C mechanical documentation to landing page
2026-10-11 refactor(mechanical): organize and rename 21 SolidWorks, STL and drawing files
2026-10-11 docs: document renamed mechanical CAD, confirmed MDF and part quantities
2026-10-11 docs: translate Neuro-PID training comments to English without changing computations
2026-10-11 docs: remove provisional upload language from PCB documentation
